haum/PCBlastifieuse/README.md

# PCBlastifieuse

Une plastifieuse A3 qui peut également transférer du toner pour fabriquer des
PCBs !
