haum/PCBlastifieuse/mesures/alim_externe/README.md

# Mesures avec alimentation externe

Ces mesures ont été réalisés avec une alimentation externe branchée sur la
carte Arduino afin de compenser les problèmes rencontrés avec l’USB.
