haum/PCBlastifieuse/mesures/usb/README.md

# Mesures avec alimentation USB uniquement

Ces mesures ont été réalisés avec le port USB comme seule source
d'alimentation.

Elles ne sont pas fiables mais restent intéressantes à analyser.

## Problèmes

Ces mesures ne sont donc pas fiables car elles peuvent dépendre d'un ordinateur
à un autre selon l'alimentation du port USB.

De plus on observe une perturbation sur le graphique des valeurs lues de la
sonde lorsque le relai s'active ; on suspecte une sous-alimentation de l’ADC
lors de l'activation du relai qui tire du courant sur le port USB.
