haum/PCBlastifieuse/schemas/sch_plastifieuse.pdf

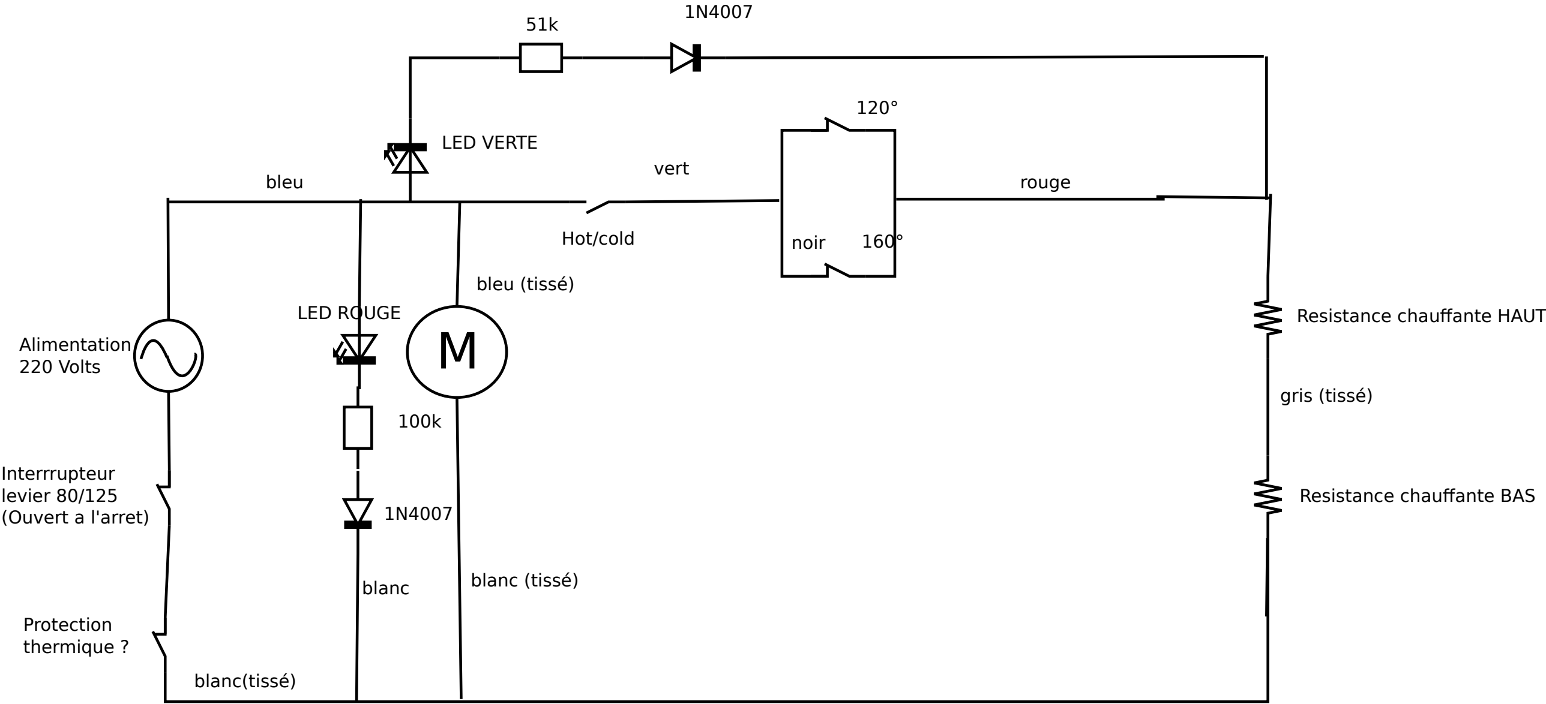
[picture p1: figure]
Hot/cold; bleu; vert; noir; rouge; bleu (tissé); LED ROUGE; Interrrupteur levier 80/125 (Ouvert a l'arret); Protection thermique ?; blanc(tissé); Alimentation 220 Volts; Resistance chauffante HAUT; Resistance chauffante BAS; gris (tissé); blanc (tissé) blanc; LED VERTE
