haum/PCBlastifieuse/mesures/README.md

# Mesures de températures

Ce dossier contient les mesures effectuées avec la sonde de température en
platine afin de l’étalonner en plaçant à côté du capteur une sonde JK et en
effectuant une régression linéaire afin d’obtenir la relation valeur numérique
↔ température.
