haum/PCBlastifieuse/schemas/README.md

# Schéma électrique de la plastifieuse

Ce dossier contient le schéma du montage électrique d’origine de la
plastifieuse.

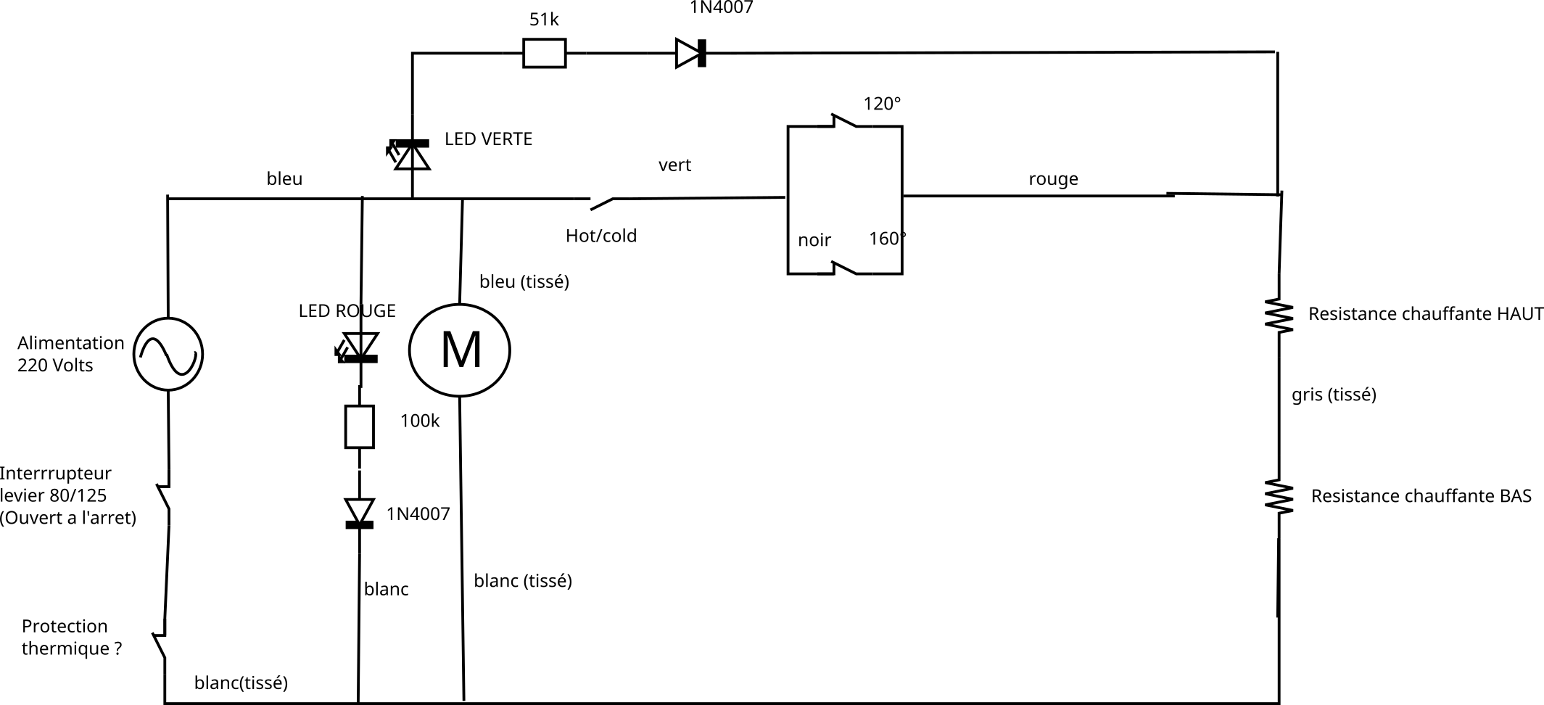
[picture p2: schemas/sch_plastifieuse.png]
Schéma
