haum/PCBlastifieuse/mesures/regulation_temp/README.md

# Mesures pour améliorer la régulation de température

Mesure réalisé avec l’alimentation externe afin de tenter d’améliorer
l’algorithme de régulation de température.
