haum/PCBlastifieuse/mesures/regulation_temp/figure_1.png

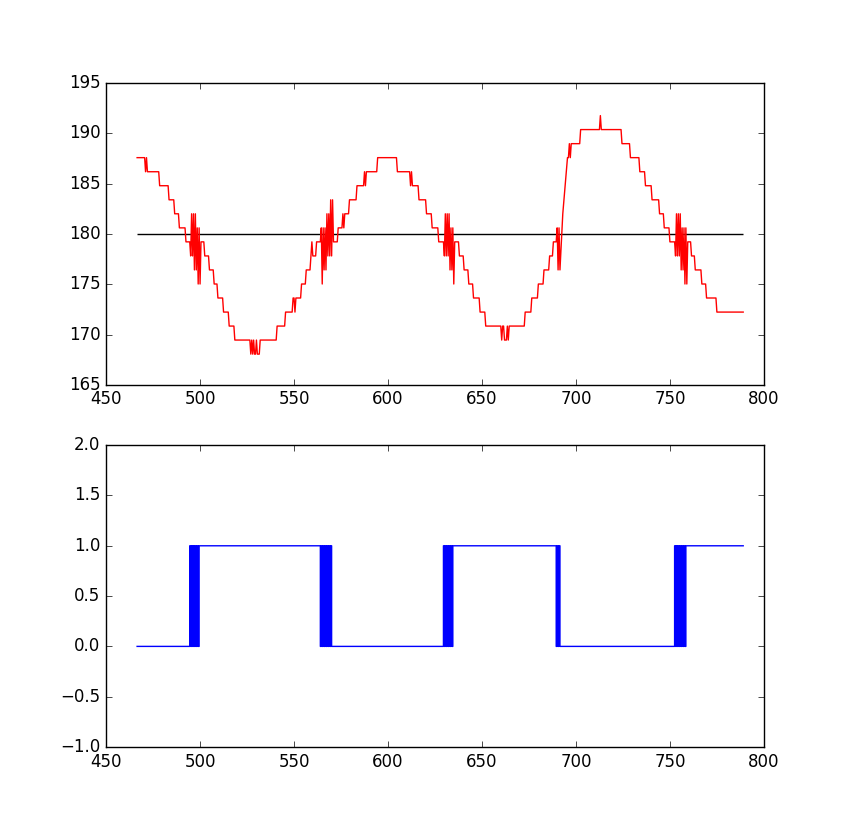
mesures/regulation_temp/figure_1.png
