haum/PCBlastifieuse/mesures/usb/graph.png

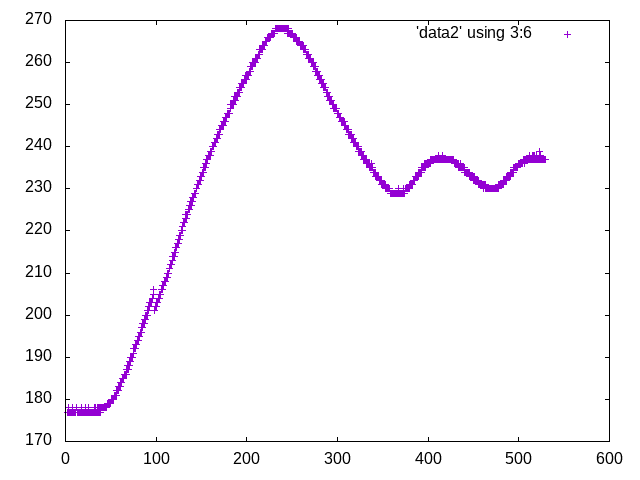
mesures/usb/graph.png
