haum/PCBlastifieuse/schemas/Grove_RTD_Sensor.pdf

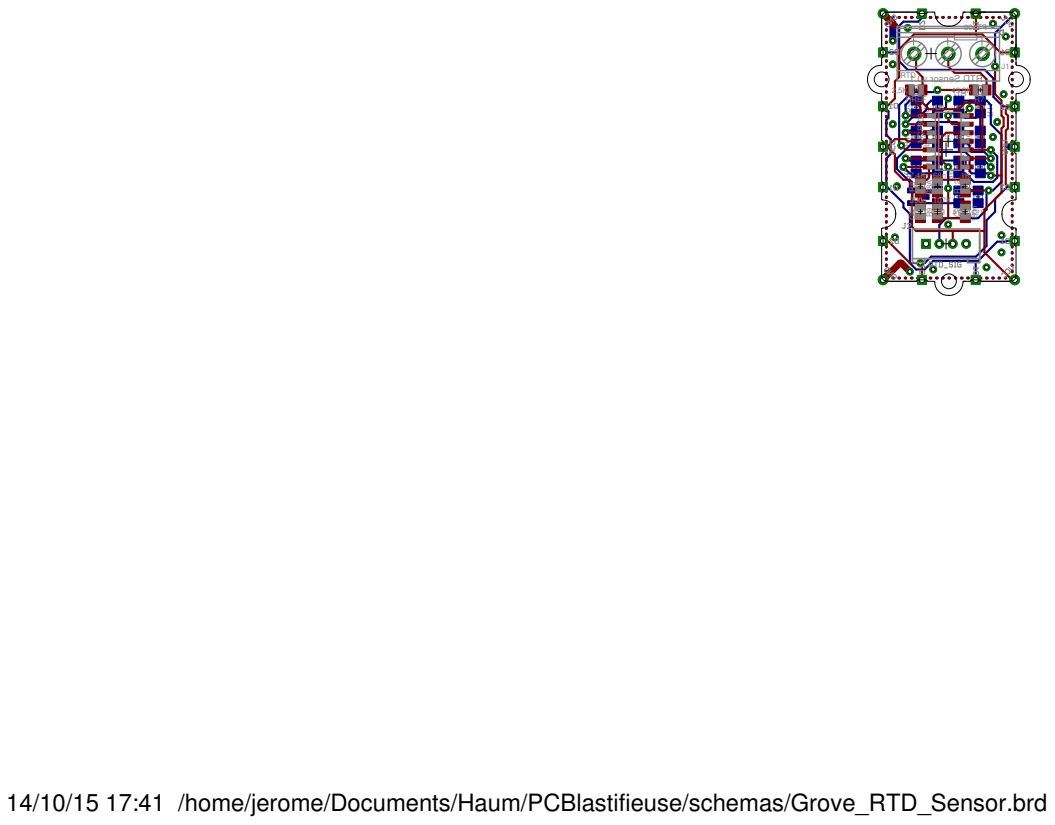
[picture p5: page 1]

14/10/15 17:41 /home/jerome/Documents/Haum/PCBlastifieuse/schemas/Grove_RTD_Sensor.brd
