haum/PCBlastifieuse/schemas/relay2.0/relayv2.pdf

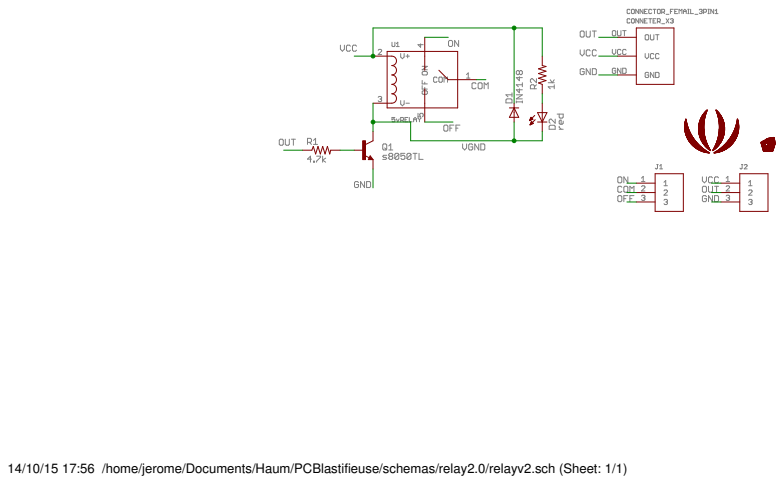
[picture p6: page 1]

14/10/15 17:56 /home/jerome/Documents/Haum/PCBlastifieuse/schemas/relay2.0/relayv2.sch (Sheet: 1/1)
