haum/PCBlastifieuse/schemas/Grove_RTD_Sensor.brd

## EAGLE design schemas/Grove_RTD_Sensor.brd (2015-12-03)

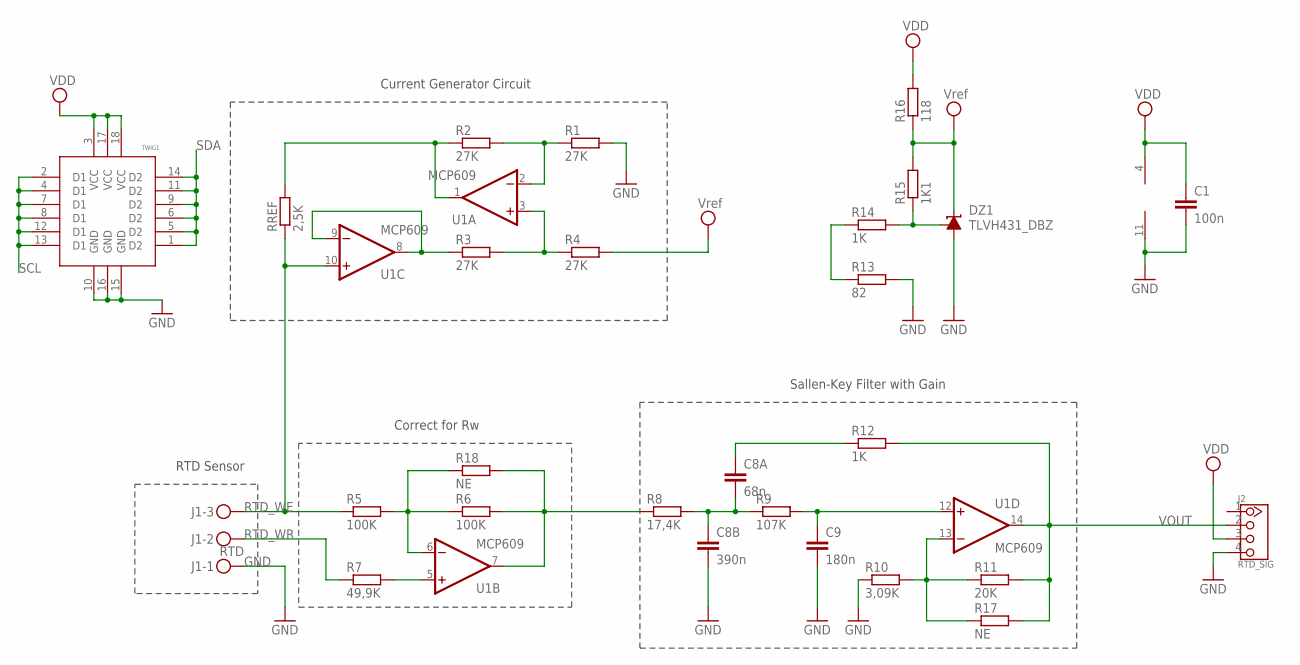
[picture p7: schematic Grove_RTD_Sensor.sch]

Parts:
C1: 100n; C0805
C8A: 68n; C0805
C8B: 390n; C0805
C9: 180n; C0805
DZ1: TLVH431_DBZ; SOT23
J1: RTD; MKDSN1,5/3-5,08
J2: RTD_SIG; 2.0_1X4
R1, R2, R3, R4: 27K; R0805
R5, R6: 100K; R0805
R7: 49,9K; R0805
R8: 17,4K; R0805
R9: 107K; R0805
R10: 3,09K; R0805
R11: 20K; R0805
R12, R14: 1K; R0805
R13: 82; R0805
R15: 1K1; R0805
R16: 118; R0805
R17, R18: NE; R0805
RREF: 2,5K; R0805
TWIG1: TWIG-U2'HOLES'; U2_HOLES
U1: MCP609; SO14

Connections:
GND: C1.2, C8B.2, C9.2, DZ1.3 (A), J1.1, J2.4, R1.2, R10.1, R13.2, TWIG1.10 (GND), TWIG1.15 (GND), TWIG1.16 (GND), U1.11 (V-)
unnamed: R1.1, R2.2, U1.2 (-IN)
unnamed: R3.2, R4.1, U1.3 (+IN)
unnamed: R2.1, RREF.2, U1.1 (OUT)
unnamed: R3.1, U1.8 (OUT), U1.9 (-IN)
unnamed: DZ1.1 (FB), R14.2, R15.1
unnamed: R6.2, R8.1, R18.2, U1.7 (OUT)
unnamed: R7.2, U1.5 (+IN)
unnamed: R5.2, R6.1, R18.1, U1.6 (-IN)
unnamed: R13.1, R14.1
unnamed: C9.1, R9.2, U1.12 (+IN)
unnamed: C8A.2, C8B.1, R8.2, R9.1
unnamed: R10.2, R11.1, R17.1, U1.13 (-IN)
unnamed: C8A.1, R12.1
RTD_WE: J1.3, R5.1, RREF.1, U1.10 (+IN)
RTD_WR: J1.2, R7.1
SCL: TWIG1.2 (D1), TWIG1.4 (D1), TWIG1.7 (D1), TWIG1.8 (D1), TWIG1.12 (D1), TWIG1.13 (D1)
SDA: TWIG1.1 (D2), TWIG1.5 (D2), TWIG1.6 (D2), TWIG1.9 (D2), TWIG1.11 (D2), TWIG1.14 (D2)
VDD: C1.1, J2.3, R16.2, TWIG1.3 (VCC), TWIG1.17 (VCC), TWIG1.18 (VCC), U1.4 (V+)
VEE: DZ1.2 (C), R4.2, R15.2, R16.1
VOUT: J2.2, R11.2, R12.2, R17.2, U1.14 (OUT)

Notes on the sheet:
Current Generator Circuit
RTD Sensor
Correct for Rw
Sallen-Key Filter with Gain

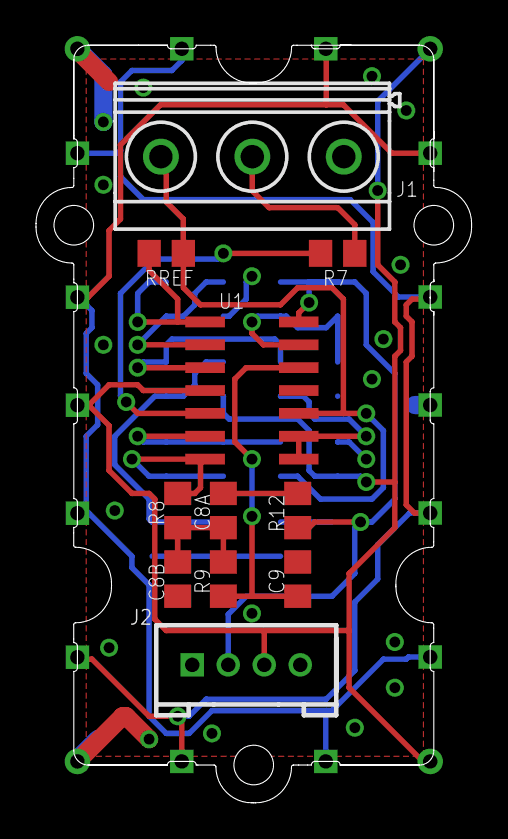
[picture p8: board Grove_RTD_Sensor.brd from above]

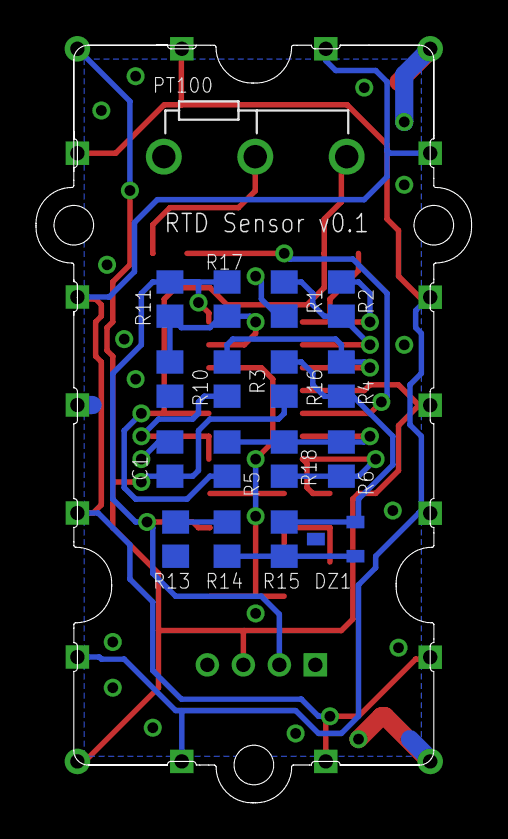
[picture p9: board Grove_RTD_Sensor.brd from below]

Board: 2 copper layers, 24.2 x 42.1 mm, 28 parts (16 on the bottom side), 21 nets.
