haum/PCBlastifieuse/(threads)

Thread 2 (2015-07-03):

Prendre une belle photo pour la page de projet

MicroJoe, 2015-07-03:
Les clichés que j'ai pu prendre détaillent étape par étape la réalisation du hack mais ne montrent pas vraiment le produit fini.

Il faudrait prendre une nouvelle photo de la plastifieuse, de préférence en fonctionnement, en train de manger une plaque d'époxy afin de lui faire une belle image de projet (en rajoutant du texte) qui pourra alors apparaitre dans la liste aléatoire sur la page d'accueil.

Un nouvel essai de transfert avec de nouveaux paramètres sera l'occasion idéale pour prendre de nouvelles photos.

Closed 2015-09-19.

Thread 3 (2015-10-12):

Régulation de température

MicroJoe, 2015-10-12:
Trouver autre chose que la comparaison actuelle car :

 - Le relai s'amuse à clignoter lorsque la valeur passe au dessus puis en dessous puis au dessus de la limite (pas possible de résoudre avec de l'hystérésis car latence énorme).
 - La température oscille entre au moins +10 et -10K par rapport au seuil étant donné l'inertie thermique importante de l'élément chauffant.

Pourquoi ne pas essayer de réaliser un truc à base de PID.

JackDesBwa, 2015-10-12:
D'après ton analyse ci-dessus, le système a un retard important entre la commande et le changement de température. Un régulateur de type PID sera très difficile à régler et probablement mauvais.

Il serait bon de réaliser quelques mesures sur la machine (avoir à la fois commande et sortie) de sorte à établir un modèle du système [premier ordre avec retard ?]. À partir de ce modèle, nous pourrions simuler le comportement et donc essayer des asservissements sans brûler la plastifieuse.

Par ailleurs, avec des systèmes à retard, une astuce est d'utiliser le modèle du processus dans la carte afin de le simuler sans retard. Celui-ci est alors asservi en virtuel et la commande est envoyée en parallèle au processus réel qui aura le même comportement un peu plus tard si le modèle est bon. Pour s'affranchir [un peu] des erreurs de modèles et des perturbations extérieures, il est possible de réinjecter l'erreur entre le modèle et la sortie effective à travers une boucle plus externe.

Je ne me souviens plus comment ça se fait exactement, mais le principe est là ; nous retrouverons les détails au moment voulu. Quoi qu'il en soit, la première étape est de modéliser le procédé.

neomilium, 2015-10-13:
Je pense qu'il y a aussi des perturbations qui sont dû à la variation de tension lors de l'enclenchement/déclenchement du relais.
Cela peut se lisser à deux niveaux : l'électronique et le code.

Une fois ce souci corrigé, plutôt qu'un PID, on peut simplement prendre en compte l'inertie (I) thermique du système de manière simple : pour atteindre un température de consigne C, on chauffe jusqu'à ce que la température (C - I+) soit atteinte et on remet en chauffe lorsque (C - I-) est atteinte. (I+ et I- étant, respectivement, l'inertie de montée, l'inertie de descente en degrés.

MicroJoe, 2015-10-14:
> Je pense qu'il y a aussi des perturbations qui sont dû à la variation de tension lors de l'enclenchement/déclenchement du relais.

Oui car quand le relai s'allume la température "chute" de genre 1°C, du coup il s'éteind, la température "remonte" de 1°C et ça explique l'oscillation et le fait que la PCBlastifieuse se comporte comme un vulgaire clignotant de voiture.

Il faudra faire une aquisition sur le port série dans un fichier afin de pouvoir analyser le couple de données `(température, relai)` et en déduire un modèle que l'on peut facilement simuler ensuite comme proposé par @JackDesBwa.

jblb, 2015-10-14:
Romain Porte <notifications@github.com> a écrit :

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

On peu aussi s'assurer matériellement que l'enclenchement du relais ne
provoque pas de chute de tension sur l'alimentation du capteur.
je pense que cette méthode est dailleurs meilleure car est est
certainement plus reproductible. Existe t'il un schéma de
lélectronique rajoutée a la plastifieuse ?

--
@+
jérôme

neomilium, 2015-10-14:
@jblb : il n'existe pas de schéma complet. Il y a une carte relai et une
carte d'interface pour la PT100.

Pour la PT100, il y a les schémas ici :
https://github.com/neomilium/grove-rtd
Pour la carte relais, c'est ici :
http://www.seeedstudio.com/wiki/index.php?title=Electronic_brick_-_5V_Relay_module_%28digital%29

Pour le reste du câblage, rien n'a été dessiné.

Le 14 octobre 2015 09:45, JbLb <notifications@github.com> a écrit :

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

--
Romuald

MicroJoe, 2015-11-11:
Je vais essayer de m'occuper de ça grace aux conseils de @JackDesBwa. Voir #4 pour le fix matériel qui va empêcher l’oscillation du relai.

JackDesBwa, 2015-11-22:
Voici en image le principe énoncé précédemment :
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

Thread 4 (2015-11-11):

Ajouter un condensateur en parallèle du relai

MicroJoe, 2015-11-11:
Pour ne pas que le relai tire trop lors de son activation et perturbe l’ADC.

jblb, 2015-11-11:
pas en parallèle du relais mais en parallèle de l'alim du relais

MicroJoe, 2015-11-11:
Oui, entre le +5 et le GND du relai ; par contre on part sur quelle valeur ? On teste avec une capacité moyenne pour voir si ça suffit ou on part dans des vrais calculs de dimensionnement ?

jblb, 2015-11-11:
220µF ou 470µF suivant ce que l'on trouve!

MicroJoe, 2015-11-20:
De toute façon il faudrait également que l'on se fasse notre propre PCB pour la carte relai de la machine ; on pourrait directement intégrer ce condensateur sur la carte plutôt que de le brancher en externe.

neomilium, 2015-11-20:
Refaire ce qui a été fait alors que c'est déjà fait? Là, il ne manque qu'un
condensateur sur le bornier et c'est bon, non ?

Le 20 novembre 2015 08:51, Romain Porte <notifications@github.com> a écrit :

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

--
Romuald

MicroJoe, 2015-11-20:
C'était dans l'optique de te rendre ta carte relai que tu voulais récupérer à la base surtout mais si tu n'y tiens pas plus que ça désormais oui on le met en externe !

neomilium, 2015-11-20:
Elle appartient au HAUM désormais. C'est vrai qu'elle très pratique pour du
prototypage rapide donc faire un PCB n'est pas une mauvaise idée en soit,
mais n'est pas une obligation.

Le 20 novembre 2015 16:20, Romain Porte <notifications@github.com> a écrit :

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

--
Romuald

MicroJoe, 2015-11-20:
Tout à fait.

Je propose donc de monter le condensateur pour vérifier l'amélioration au niveau de la mesure et dans un futur plus lointain se refaire une carte si on trouve un relai adéquat.

neomilium, 2015-11-20:
+1

Le 20 novembre 2015 19:25, Romain Porte <notifications@github.com> a écrit :

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

--
Romuald
