haum/PCBlastifieuse/(commit log)

2015-06-26 Ajout code source carte Arduino
2015-06-26 Ajout des mesures effectuées
    [regression_lineaire.ods]
2015-12-03 ajout documentation - schemas relay et conditioneur de capteur de temperature PCBlastivieuse V1 - Documents utilisation controleur PID PCBlastifieuse V2
    [Grove_RTD_Sensor.brd, Grove_RTD_Sensor.sch, relayv2.brd, relayv2.sch]
